mcejp/overkill-cyclometer/sw/assets/fonts/curses_vector_8x12.png

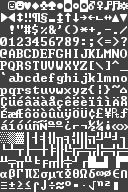
sw/assets/fonts/curses_vector_8x12.png
