mcejp/overkill-cyclometer/mechanical/ecu-v2-housing/v2_housing_prototype_r3_bottom.3mf

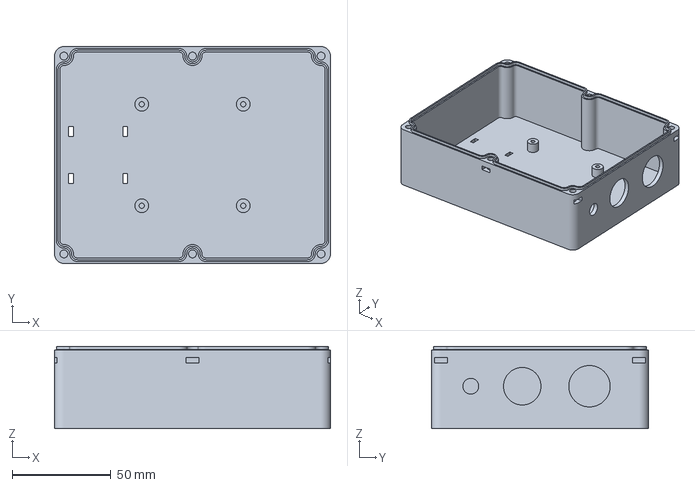
[picture p2: CAD file, 2022-02-25]
mechanical/ecu-v2-housing/v2_housing_prototype_r3_bottom.3mf
140.0 x 110.0 x 41.7 mm
