mcejp/overkill-cyclometer/mechanical/oled-housing/oled_lid.stl

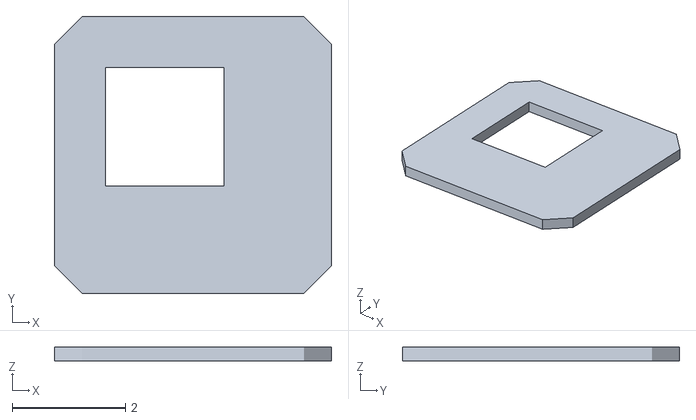
[picture p3: CAD file, 2021-10-14]
mechanical/oled-housing/oled_lid.stl
4.90 x 4.90 x 0.25
