mcejp/overkill-cyclometer/mechanical/oled-housing/oled_base.stl

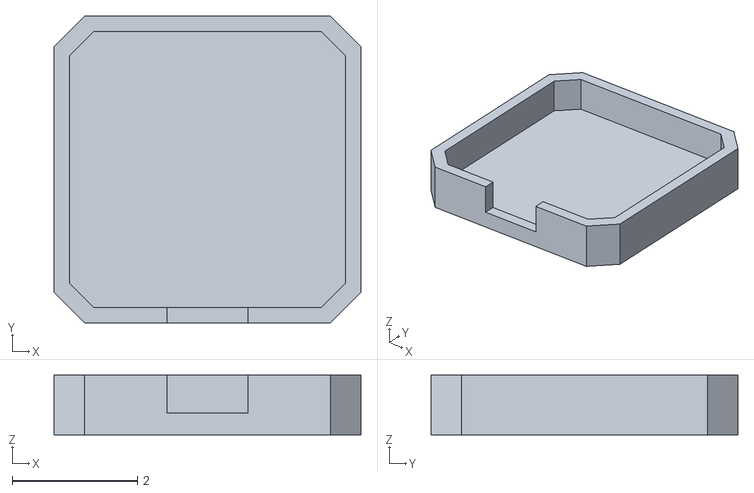
[picture p4: CAD file, 2021-10-14]
mechanical/oled-housing/oled_base.stl
4.90 x 4.90 x 0.95
