mcejp/overkill-cyclometer/(list of files, cad)

Other CAD files:
mechanical/ecu-v2-housing/v2_housing_prototype_r3_bottom.stl
