mcejp/overkill-cyclometer/hw/bikECU-v2.1-PCB/bikECU-v2.1-PCB.kicad_pcb

## KiCad design hw/bikECU-v2.1-PCB/bikECU-v2.1-PCB.kicad_pcb (2022-05-11)

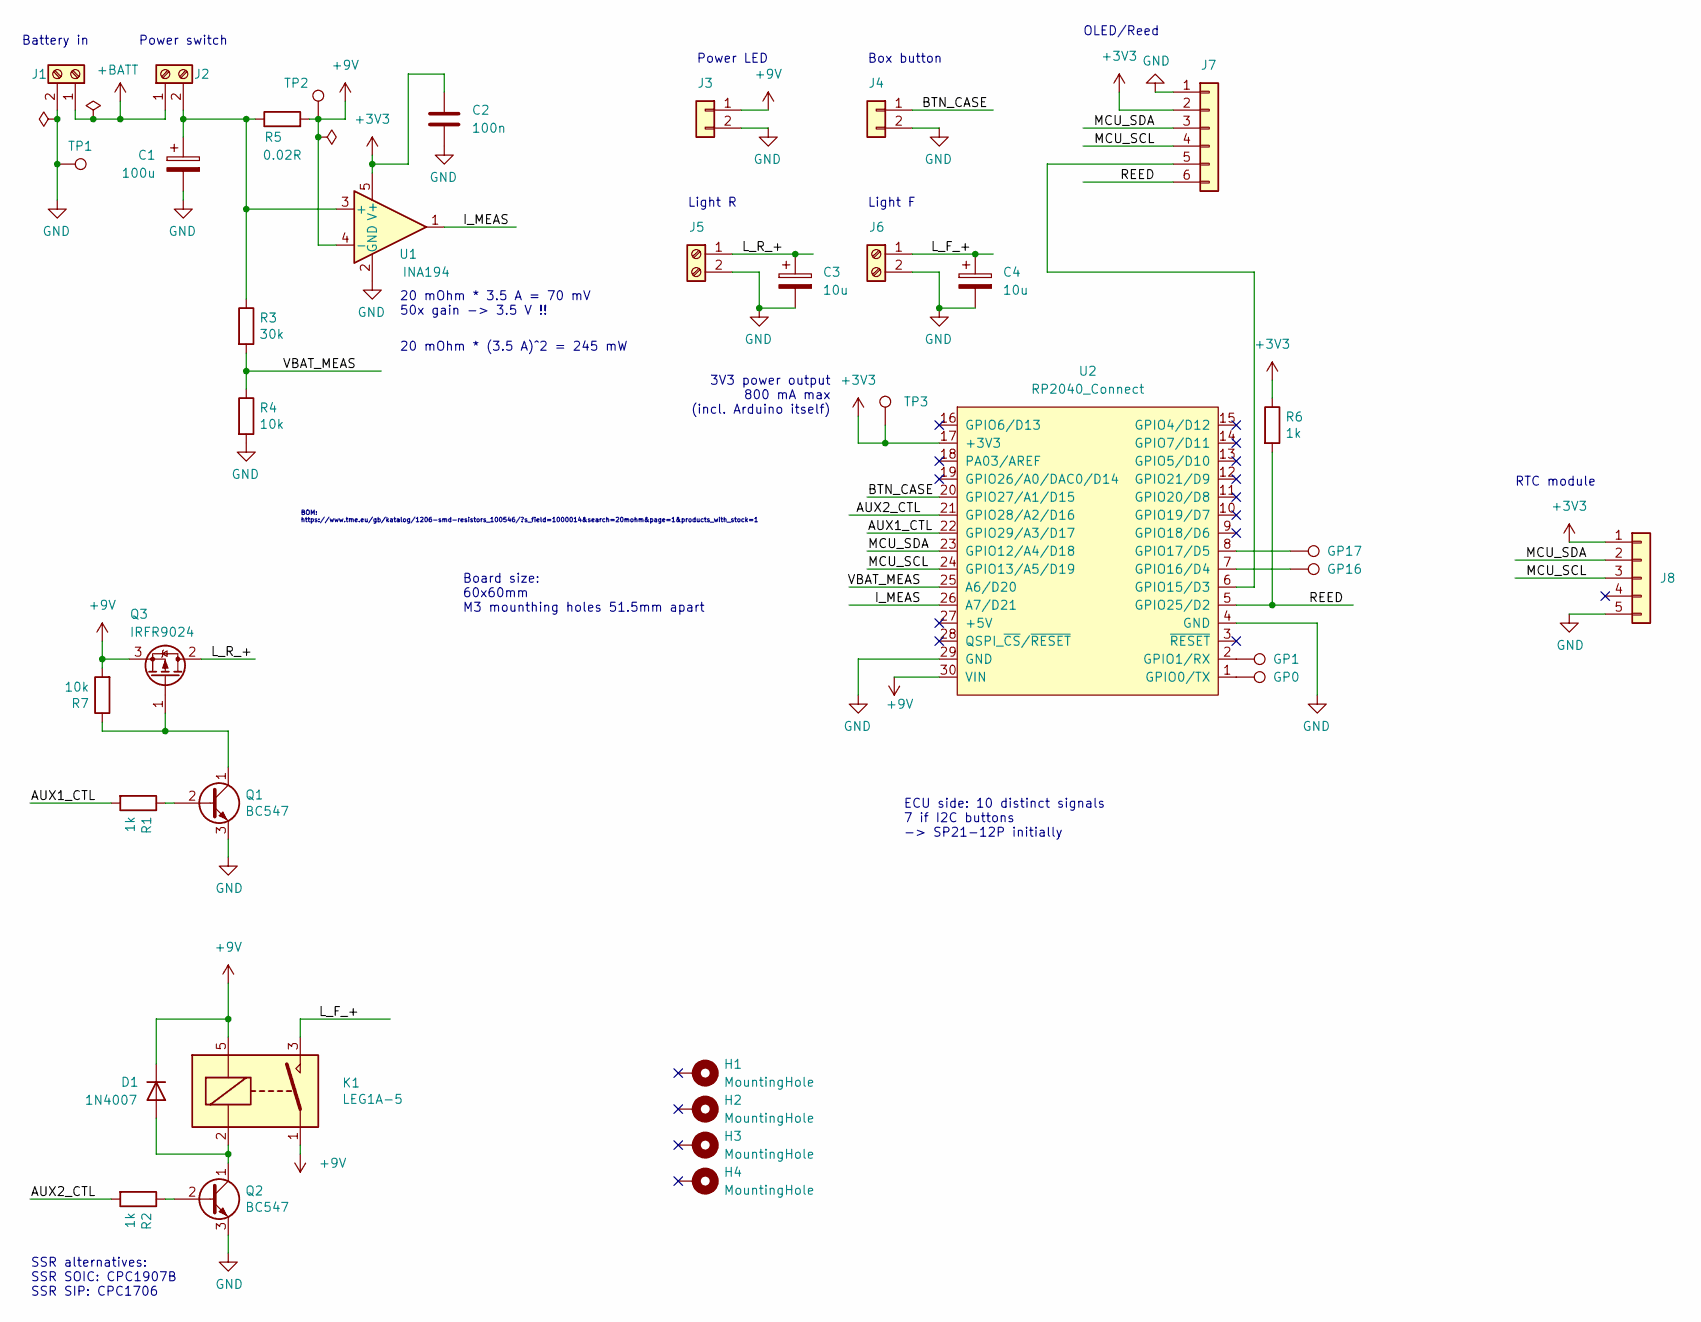
[picture p5: schematic bikECU-v2.1-PCB.kicad_sch]

Parts:
C1: 100u; CP_Radial_D6.3mm_P2.50mm
C2: 100n; C_0805_2012Metric_Pad1.18x1.45mm_HandSolder
C3, C4: 10u; CP_Radial_D5.0mm_P2.00mm
D1: 1N4007; D_DO-41_SOD81_P10.16mm_Horizontal
GP0, GP1, GP16, GP17: TestPoint; TestPoint_THTPad_D2.0mm_Drill1.0mm
H1, H2, H3, H4: MountingHole; MountingHole_3.2mm_M3_Pad
J1: Power_in; TerminalBlock_TE_282834-2_1x02_P2.54mm_Horizontal
J2: Power_sw; TerminalBlock_TE_282834-2_1x02_P2.54mm_Horizontal
J3: Power_led; JST_PH_B2B-PH-K_1x02_P2.00mm_Vertical
J4: Btn_box; JST_PH_B2B-PH-K_1x02_P2.00mm_Vertical
J5: Light_R; TerminalBlock_TE_282834-2_1x02_P2.54mm_Horizontal
J6: Light_F; TerminalBlock_TE_282834-2_1x02_P2.54mm_Horizontal
J7: Harness_conn; JST_PH_B6B-PH-K_1x06_P2.00mm_Vertical
J8: Rtc_hdr; PinHeader_1x05_P2.54mm_Vertical
K1: LEG1A-5; Relay_SPST_SANYOU_SRD_Series_Form_A
Q1, Q2: BC547; TO-92_Inline
Q3: IRFR9024; TO-252-2
R1, R2, R6: 1k; R_Axial_DIN0207_L6.3mm_D2.5mm_P10.16mm_Horizontal
R3: 30k; R_Axial_DIN0207_L6.3mm_D2.5mm_P10.16mm_Horizontal
R4, R7: 10k; R_Axial_DIN0207_L6.3mm_D2.5mm_P10.16mm_Horizontal
R5: 0.02R; R_1210_3225Metric_Pad1.30x2.65mm_HandSolder
TP1: GND; TestPoint_Pad_2.0x2.0mm
TP2: 9V; TestPoint_Pad_2.0x2.0mm
TP3: 3V3; TestPoint_Pad_2.0x2.0mm
U1: INA194; SOT-23-5_HandSoldering
U2: RP2040_Connect

Connections:
+3V3: C2.1, J7.2, J8.1, R6.1, TP3.1, U1.5 (V+), U2.17 (+3V3)
+9V: D1.1 (K), J3.1, K1.1, K1.5, Q3.3 (S), R5.2, R7.2, TP2.1, U1.4 (-), U2.30 (VIN)
+BATT: J1.1, J2.1
/AUX1_CTL: R1.2, U2.22 (GPIO29/A3/D17)
/AUX2_CTL: R2.2, U2.21 (GPIO28/A2/D16)
/BTN_CASE: J4.1, U2.20 (GPIO27/A1/D15)
/I_MEAS: U1.1, U2.26 (A7/D21)
/L_F_+: C4.1, J6.1, K1.3
/L_R_+: C3.1, J5.1, Q3.2 (D)
/MCU_SCL: J7.4, J8.3, U2.24 (GPIO13/A5/D19)
/MCU_SDA: J7.3, J8.2, U2.23 (GPIO12/A4/D18)
/REED: J7.6, R6.2, U2.5 (GPIO25/D2)
/VBAT_MEAS: R3.2, R4.1, U2.25 (A6/D20)
GND: C1.2, C2.2, C3.2, C4.2, J1.2, J3.2, J4.2, J5.2, J6.2, J7.1, J8.5, Q1.3 (E), Q2.3 (E), R4.2, TP1.1, U1.2 (GND), U2.4 (GND), U2.29 (GND)
unnamed: C1.1, J2.2, R3.1, R5.1, U1.3 (+)
unnamed: J7.5, U2.6 (GPIO15/D3)
unnamed: D1.2 (A), K1.2, Q2.1 (C)
unnamed: Q1.1 (C), Q3.1 (G), R7.1
unnamed: Q1.2 (B), R1.1
unnamed: Q2.2 (B), R2.1
unnamed: GP0.1, U2.1 (GPIO0/TX)
unnamed: GP1.1, U2.2 (GPIO1/RX)
unnamed: GP16.1, U2.7 (GPIO16/D4)
unnamed: GP17.1, U2.8 (GPIO17/D5)

Notes on the sheet:
20 mOhm * 3.5 A = 70 mV 50x gain -> 3.5 V !!
Power LED
BOM: https://www.tme.eu/gb/katalog/1206-smd-resistors_100546/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
OLED/Reed
RTC module
Light F
Power switch
SSR alternatives: SSR SOIC: CPC1907B SSR SIP: CPC1706
Light R
Board size: 60x60mm M3 mounthing holes 51.5mm apart
Box button
Battery in
ECU side: 10 distinct signals 7 if I2C buttons -> SP21-12P initially
20 mOhm * (3.5 A)^2 = 245 mW
3V3 power output 800 mA max (incl. Arduino itself)

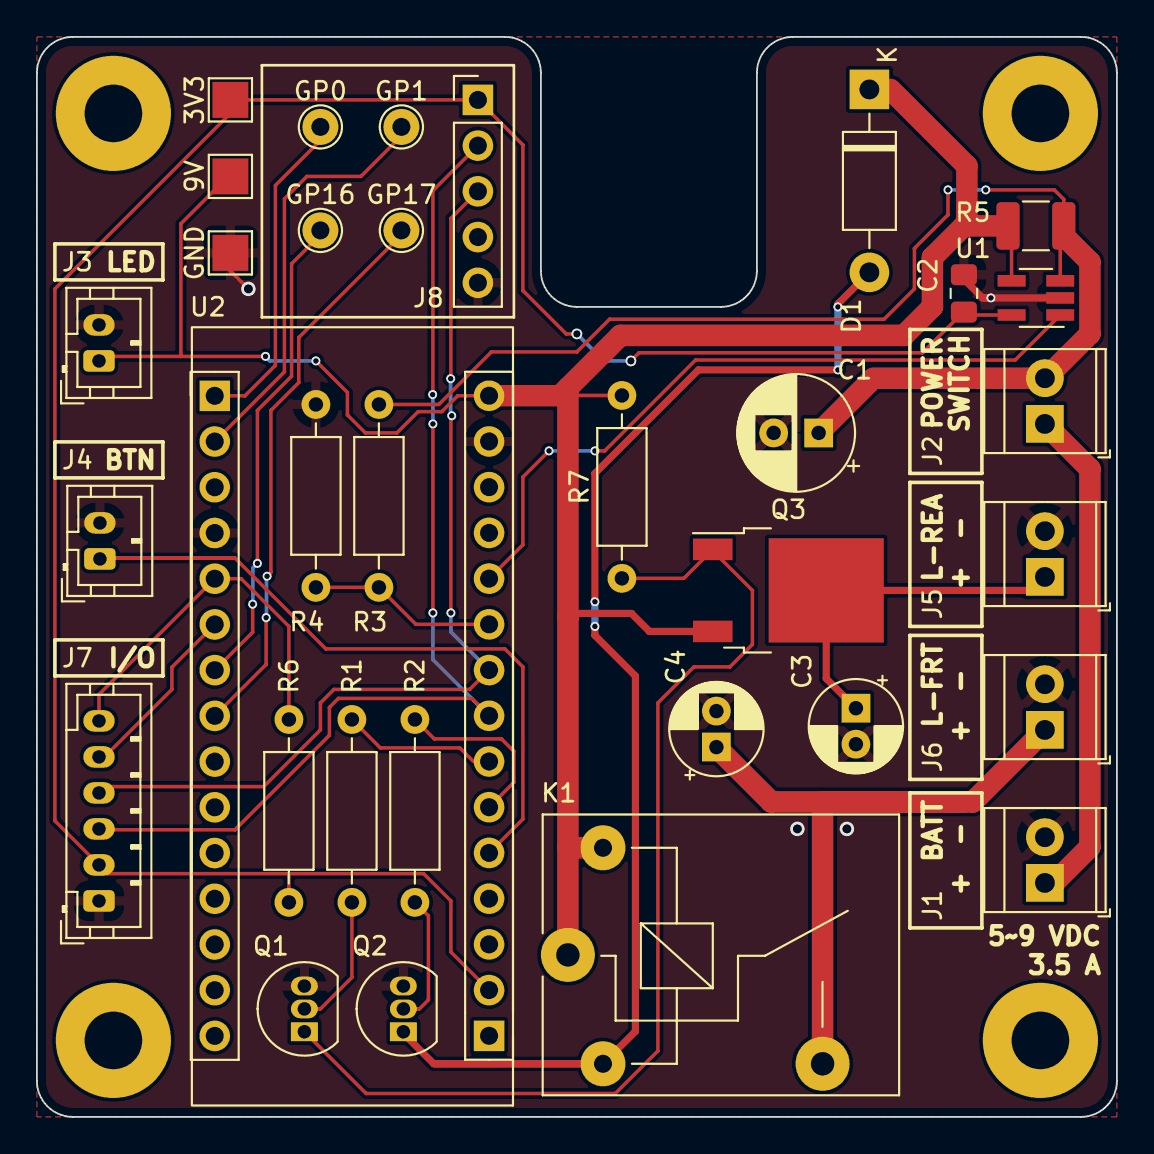
[picture p6: board bikECU-v2.1-PCB.kicad_pcb from above]

Board: 2 copper layers, 60.0 x 60.0 mm, 37 parts (0 on the bottom side), 24 nets.
