mcejp/overkill-cyclometer/sw/main.cpp

#include "app.hpp"
#include "devprop.hpp"
#include "ds3231.hpp"
#include "storage.hpp"
#include "SeeedGrayOLED.h"

#include "hardware/adc.h"
#include "hardware/i2c.h"
#include "hardware/sync.h"
#include "pico/stdlib.h"

#include <stdio.h>
#include <string.h>

using std::optional;

enum {
    ADC_IN_GPIO26,
    ADC_IN_GPIO27,
    ADC_IN_GPIO28,
    ADC_IN_GPIO29,
    ADC_IN_ONBOARD_TEMP,
};

const auto ADC_IN_VBAT = ADC_IN_GPIO26;
const auto ADC_IN_IBAT = ADC_IN_GPIO27;

// 12-bit conversion, assume max value == ADC_VREF == 3.3 V
constexpr float ADC_TO_VOLTS = 3.3f / (1 << 12);

// 30:10 kOhm voltage divider
constexpr float VBAT_RECIPROCAL_CONVERSION_FACTOR = 1.0f / (10.0f / (10.0f + 30.0f));

// 10 mOhm sensing resistor (instead of 20 mOhm as per schematic), 50x INA gain
constexpr float IBAT_RECIPROCAL_CONVERSION_FACTOR = 1.0f / (0.010f * 50);

static void init_adc() {
    adc_init();

    // Make sure GPIO is high-impedance, no pullups etc
    // This actually matters! We get a wrong reading otherwise!
    adc_gpio_init(26);
    adc_gpio_init(27);

    adc_set_temp_sensor_enabled(true);
}

static void adc_demo() {
    adc_select_input(ADC_IN_ONBOARD_TEMP);
    sleep_ms(100);

    for (int i = 0; i < 5; i++) {
        const uint16_t result = adc_read();
        const auto ADC_Voltage = result * ADC_TO_VOLTS;
        const auto T = 27 - (ADC_Voltage - 0.706f)/0.001721f;
        printf("Raw value: 0x%03x, voltage: %f V, temp: %.1f degC\n", result, ADC_Voltage, T);
        sleep_ms(500);
    }

    //adc_set_temp_sensor_enabled(false);

    adc_select_input(ADC_IN_VBAT);

    for (int i = 0; i < 5; i++) {
        const uint16_t result = adc_read();
        const auto adc_volts = result * ADC_TO_VOLTS;
        const auto V_bat = adc_volts * VBAT_RECIPROCAL_CONVERSION_FACTOR;
        printf("V_bat raw value: 0x%03x, voltage: %f V, corrected: %f V\n", result, adc_volts, V_bat);
        sleep_ms(200);
    }

    adc_select_input(ADC_IN_IBAT);

    for (int i = 0; i < 5; i++) {
        const uint16_t result = adc_read();
        const auto adc_volts = result * ADC_TO_VOLTS;
        const auto I_bat = adc_volts * IBAT_RECIPROCAL_CONVERSION_FACTOR;
        printf("I_bat raw value: 0x%03x, voltage: %f V, corrected: %f A\n", result, adc_volts, I_bat);
        sleep_ms(200);
        //sleep_ms(800); i = 0;
    }
}

void platformSendCommand(unsigned char command) {
    i2c_inst_t *i2c = i2c0;
    uint8_t data[2];
    data[0] = SeeedGrayOLED_Command_Mode;
    data[1] = command;

    i2c_write_blocking(i2c, SeeedGrayOLED_Address, data, 2, false);
}

void platformSendData(unsigned char command) {
    i2c_inst_t *i2c = i2c0;
    uint8_t data[2];
    data[0] = SeeedGrayOLED_Data_Mode;
    data[1] = command;

    i2c_write_blocking(i2c, SeeedGrayOLED_Address, data, 2, false);
}

static void i2c_demo() {
    i2c_inst_t *i2c = i2c0;

    printf("I2C demo\n");

    i2c_init(i2c, 400 * 1000);

    // Pins
    const uint sda_pin = 12;
    const uint scl_pin = 13;

    gpio_set_function(sda_pin, GPIO_FUNC_I2C);
    gpio_set_function(scl_pin, GPIO_FUNC_I2C);
    gpio_pull_up(sda_pin);
    gpio_pull_up(scl_pin);

    SeeedGrayOled.init(SH1107G);             //initialize SEEED OLED display
    sleep_ms(2000);
    SeeedGrayOled.clearDisplay();     //Clear Display.
    SeeedGrayOled.setNormalDisplay(); //Set Normal Display Mode
    SeeedGrayOled.setVerticalMode();  // Set to vertical mode for displaying text

    //for (char i = 0; i < 16 ; i++) {
    //    SeeedGrayOled.setTextXY(i, 0); //set Cursor to ith line, 0th column
    //    SeeedGrayOled.setGrayLevel(i); //Set Grayscale level. Any number between 0 - 15.
    //    SeeedGrayOled.putString("Hello World OLED"); //Print Hello World
    //}

    printf("I2C demo done\n");
}

const uint LED_PIN = 6;
const uint MY_INPUT_PIN = 25;
const uint AUX1_CTL_PIN = 29;

static volatile EventBuffer evb;

// https://github.com/raspberrypi/pico-examples/blob/master/gpio/hello_gpio_irq/hello_gpio_irq.c
static void gpio_callback(uint gpio, uint32_t events) {
    static uint64_t last_fall;

    gpio_put(LED_PIN, !gpio_get(MY_INPUT_PIN));

    auto now = time_us_64();

    if (events & GPIO_IRQ_EDGE_FALL) {
        last_fall = now;
    }
    else if (events & GPIO_IRQ_EDGE_RISE) {
        // ignore short glitches (threshold empirical)
        if (now - last_fall < 20) {
            return;
        }

        static uint64_t last_timestamp = 0;
        static uint32_t idx = 0;

        if (now > last_timestamp + MIN_INTERVAL_MS * 1000) {
            evb.timestamps[idx] = now;
            idx = (idx + 1) % evb.NUM_ENTRIES;
            last_timestamp = now;
        }
    }
}

#pragma clang diagnostic push
#pragma ide diagnostic ignored "EndlessLoop"
int main() {
    stdio_init_all();
    //sleep_ms(1000);

    init_adc();
    //adc_demo();

    gpio_init(AUX1_CTL_PIN);
    gpio_set_dir(AUX1_CTL_PIN, GPIO_OUT);
    gpio_put(AUX1_CTL_PIN, 1);

    gpio_init(MY_INPUT_PIN);
    gpio_set_dir(MY_INPUT_PIN, GPIO_IN);
    gpio_pull_up(MY_INPUT_PIN);

    gpio_init(LED_PIN);
    gpio_set_dir(LED_PIN, GPIO_OUT);

    gpio_put(LED_PIN, 1);
    sleep_ms(100);
    gpio_put(LED_PIN, 0);

    i2c_demo();

    storage_init();

    // init devprop
    dp_node_init_bikECU(&inst);

    auto next_wakeup = get_absolute_time();

    //printf("entering app.\n");
    app::init();

    gpio_set_irq_enabled_with_callback(MY_INPUT_PIN, GPIO_IRQ_EDGE_RISE | GPIO_IRQ_EDGE_FALL, true, &gpio_callback);

    DevpropReceiver devprop;

    while (true) {
        // TODO: interrupt-driven wake up can save a tiny bit of power
        sleep_ms(50);

        auto now = get_absolute_time();

        // wake-up due?
        if (absolute_time_diff_us(next_wakeup, now) >= 0) {
            next_wakeup = delayed_by_ms(next_wakeup, UPDATE_PERIOD_MS);

            EventBuffer evb_snapshot;

            // TODO: is this C++-legal?
            uint32_t ints = save_and_disable_interrupts();
            memcpy(&evb_snapshot, (const void*) &evb, sizeof(evb));
            restore_interrupts(ints);

            app::wakecycle(to_us_since_boot(now), evb_snapshot, app::SensorInputs {});
        }

        // Feed devprop receiver
        for (int ch; (ch = getchar_timeout_us(0)) != PICO_ERROR_TIMEOUT; ) {
            devprop.handle_recv(ch);
        }
    }
}

#pragma clang diagnostic pop

float platform::get_ambient_temperature() {
    adc_select_input(ADC_IN_ONBOARD_TEMP);
    sleep_ms(20);

    uint16_t result = adc_read();
    auto adc_volts = result * ADC_TO_VOLTS;
    return 27 - (adc_volts - 0.706f)/0.001721f;
}

tm platform::get_current_time() {
    return ds3231::to_tm(ds3231::read_registers());
}

float platform::get_Ibat() {
    adc_select_input(ADC_IN_IBAT);
    sleep_ms(20);

    auto result = adc_read();
    auto adc_volts = result * ADC_TO_VOLTS;
    return adc_volts * IBAT_RECIPROCAL_CONVERSION_FACTOR;
}

float platform::get_Vbat() {
    adc_select_input(ADC_IN_VBAT);
    sleep_ms(20);       // TODO: reference for this magic number?

    auto result = adc_read();
    auto adc_volts = result * ADC_TO_VOLTS;
    return adc_volts * VBAT_RECIPROCAL_CONVERSION_FACTOR;
}
