mcejp/overkill-cyclometer/(commit log)

2021-10-14 Add OLED housing models
    [oled_base.stl, oled_lid.stl]
2021-10-15 Add connector datasheet
2021-11-24 First iteration of sensor spacer
    [spacer.scad]
2021-11-25 Sensor spacer, take II
    [spacer.scad]
2021-12-12 Sensor spacer post-print adjustments
    [spacer.scad]
2022-02-25 Add v2 ECU housing
    [UltimateWaterproofCase_V6.scad, v2_housing_prototype_r3_bottom.3mf, v2_housing_prototype_r3_bottom.stl]
2022-02-25 Add KiCad project for v2 system design
    [bikECU-v2-sysdesign.sch]
2022-05-11 Port to Arduino RP2040 Connect
2022-05-11 De-glitch sensor input
2022-05-11 Add v2.1 PCB design
    [bikECU-v2.1-PCB.kicad_pcb, bikECU-v2.1-PCB.kicad_sch]
2023-05-29 Show a clock + alternate between V_bat and ambient temperature
